TuriSc/portami/midi_interface.ino

/*
 * Copyright (c) 2021 Marcel Licence
 *
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
 * Dieses Programm ist Freie Software: Sie können es unter den Bedingungen
 * der GNU General Public License, wie von der Free Software Foundation,
 * Version 3 der Lizenz oder (nach Ihrer Wahl) jeder neueren
 * veröffentlichten Version, weiter verteilen und/oder modifizieren.
 *
 * Dieses Programm wird in der Hoffnung bereitgestellt, dass es nützlich sein wird, jedoch
 * OHNE JEDE GEWÄHR,; sogar ohne die implizite
 * Gewähr der MARKTFÄHIGKEIT oder EIGNUNG FÜR EINEN BESTIMMTEN ZWECK.
 * Siehe die GNU General Public License für weitere Einzelheiten.
 *
 * Sie sollten eine Kopie der GNU General Public License zusammen mit diesem
 * Programm erhalten haben. Wenn nicht, siehe <https://www.gnu.org/licenses/>.
 */

/**
 * @file midi_interface.ino
 * @author Marcel Licence
 * @date 22.10.2021
 *
 * @brief This file contains an implementation of a simple MIDI interpreter to parse incoming messages
 *
 * @see https://www.midi.org/specifications-old/item/table-1-summary-of-midi-message
 *
 * @contribution 18.12.2022 by Turi Scandurra: switching reading data from serial to USB
 */


#ifdef __CDT_PARSER__
#include <cdt.h>
#endif
#include <Arduino.h>
#include <usbh_midi.h>
#include <usbhub.h>

USBHost UsbH;
USBHub Hub(&UsbH);
USBH_MIDI  Midi(&UsbH);

/* use define to dump midi data */
#define MIDI_DUMP_Serial1_TO_SERIAL

/*
 * look for midi interface using 1N136
 * to convert the MIDI din signal to
 * a uart compatible signal
 */

#ifndef MIDI_SERIAL1_BAUDRATE
#define MIDI_SERIAL1_BAUDRATE   115200 // 31250
#endif


/*
 * structure is used to build the mapping table
 */
struct midiControllerMapping
{
    uint8_t channel;
    uint8_t data1;
    const char *desc;
    void(*callback_mid)(uint8_t ch, uint8_t data1, uint8_t data2);
    void(*callback_val)(uint8_t userdata, float value);
    uint8_t user_data;
};

struct midiMapping_s
{
    void (*rawMsg)(uint8_t *msg);
    void (*noteOn)(uint8_t ch, uint8_t note, float vel);
    void (*noteOff)(uint8_t ch, uint8_t note);
    void (*pitchBend)(uint8_t ch, float bend);
    void (*modWheel)(uint8_t ch, float value);

    struct midiControllerMapping *controlMapping;
    int mapSize;
};

extern struct midiMapping_s midiMapping; /* definition in z_config.ino */

/* constant to normalize midi value to 0.0 - 1.0f */
#define NORM127MUL  0.007874f

inline void Midi_NoteOn(uint8_t ch, uint8_t note, uint8_t vel)
{
    if (vel > 127)
    {
        /* we will end up here in case of problems with the MIDI connection or a bug in the parser */
        vel = 127;
        Serial.printf("to loud note detected!!!!!!!!!!!!!!!!!!!!!!!\n");
    }

    if (midiMapping.noteOn != NULL)
    {
        midiMapping.noteOn(ch, note, pow(2, ((vel * NORM127MUL) - 1.0f) * 6));
    }
}

inline void Midi_NoteOff(uint8_t ch, uint8_t note)
{
    if (midiMapping.noteOff != NULL)
    {
        midiMapping.noteOff(ch, note);
    }
}

/*
 * this function will be called when a control change message has been received
 */
inline void Midi_ControlChange(uint8_t channel, uint8_t data1, uint8_t data2)
{
    for (int i = 0; i < midiMapping.mapSize; i++)
    {
        if ((midiMapping.controlMapping[i].channel == channel) && (midiMapping.controlMapping[i].data1 == data1))
        {
            if (midiMapping.controlMapping[i].callback_mid != NULL)
            {
                midiMapping.controlMapping[i].callback_mid(channel, data1, data2);
            }
            if (midiMapping.controlMapping[i].callback_val != NULL)
            {
                midiMapping.controlMapping[i].callback_val(midiMapping.controlMapping[i].user_data, (float)data2 * NORM127MUL);
            }
        }
    }

    if (data1 == 1)
    {
        if (midiMapping.modWheel != NULL)
        {
            midiMapping.modWheel(channel, (float)data2 * NORM127MUL);
        }
    }
}

inline void Midi_PitchBend(uint8_t ch, uint16_t bend)
{
    float value = ((float)bend - 8192.0f) * (1.0f / 8192.0f) - 1.0f;
    if (midiMapping.pitchBend != NULL)
    {
        Serial.printf("PB: %d, %d, %d\n", ch, bend, (value * 1000.0f));
        midiMapping.pitchBend(ch, value);
    }
}

/*
 * function will be called when a short message has been received over midi
 */
inline void Midi_HandleShortMsg(uint8_t *data, uint8_t cable)
{
    uint8_t ch = data[0] & 0x0F;

    switch (data[0] & 0xF0)
    {
    /* note on */
    case 0x90:
        if (data[2] > 0)
        {
            Midi_NoteOn(ch, data[1], data[2]);
        }
        else
        {
            Midi_NoteOff(ch, data[1]);
        }
        break;
    /* note off */
    case 0x80:
        Midi_NoteOff(ch, data[1]);
        break;
    /* control change */
    case 0xb0:
        Midi_ControlChange(ch, data[1], data[2]);
        break;
    /* pitch bend */
    case 0xe0:
        Midi_PitchBend(ch, ((((uint16_t)data[1])) + ((uint16_t)data[2] << 8)));
        break;
    }
}

void Midi_Setup()
{
    Serial1.begin(MIDI_SERIAL1_BAUDRATE);
    if (UsbH.Init()) {
      Serial1.println("USB host did not start");
      while (1); //halt
    }

    while (!Serial);
    Serial1.println("Serial1 started");
}


inline
void Midi_CheckUSB(void)
{
  static uint8_t inMsg[3];
  char buf[20];
  uint8_t bufMidi[64];
  uint16_t  rcvd;

  if (Midi.RecvData(&rcvd,  bufMidi) == 0 ) {
    uint32_t time = (uint32_t)millis();
    sprintf(buf, "%04X%04X: ", (uint16_t)(time >> 16), (uint16_t)(time & 0xFFFF)); // Split variable to prevent warnings on the ESP8266 platform
    Serial1.print(buf);
    Serial1.print(rcvd);
    Serial1.print(':');
    for (int i = 0; i < 64; i++) {
      sprintf(buf, " %02X", bufMidi[i]);
      Serial1.print(buf);
    }
  }

  if(bufMidi[1] == 0x80 || bufMidi[1] == 0x90 || bufMidi[1] == 0xb0 || bufMidi[1] == 0xe0){
    inMsg[0] = bufMidi[1]; // Status: Note On, Note Off…
    inMsg[1] = bufMidi[2]; // Data 1: Note Number, Program Number…
    inMsg[2] = bufMidi[3]; // Data 2: Velocity, Pressure…
    Midi_HandleShortMsg(inMsg, 0);
  }

}


/*
 * this function should be called continuously to ensure that incoming messages can be processed
 */
inline
void Midi_Process()
{
    if ( Midi ) {
      Midi_CheckUSB();
    }
}
