TuriSc/portami/z_config.ino

/*
 * Copyright (c) 2021 Marcel Licence
 *
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
 * Dieses Programm ist Freie Software: Sie können es unter den Bedingungen
 * der GNU General Public License, wie von der Free Software Foundation,
 * Version 3 der Lizenz oder (nach Ihrer Wahl) jeder neueren
 * veröffentlichten Version, weiter verteilen und/oder modifizieren.
 *
 * Dieses Programm wird in der Hoffnung bereitgestellt, dass es nützlich sein wird, jedoch
 * OHNE JEDE GEWÄHR,; sogar ohne die implizite
 * Gewähr der MARKTFÄHIGKEIT oder EIGNUNG FÜR EINEN BESTIMMTEN ZWECK.
 * Siehe die GNU General Public License für weitere Einzelheiten.
 *
 * Sie sollten eine Kopie der GNU General Public License zusammen mit diesem
 * Programm erhalten haben. Wenn nicht, siehe <https://www.gnu.org/licenses/>.
 */

/**
 * @file z_config.ino
 * @author Marcel Licence
 * @date 15.05.2021
 *
 * @brief This file contains the mapping configuration
 * Put all your project configuration here (no defines etc)
 * This file will be included at the and can access all
 * declarations and type definitions
 *
 * @see ESP32 Arduino DIY Synthesizer Projects - Little startup guide to get your MIDI synth working - https://youtu.be/ZNxGCB-d68g
 *
 * @contribution 18.12.2022 by Turi Scandurra: added mapping for AKAI MPK Mini Play
 */

#ifdef __CDT_PARSER__
#include <cdt.h>
#endif


/*
 * this mapping is used for the edirol pcr-800
 * this should be changed when using another controller
 */
struct midiControllerMapping edirolMapping[] =
{
    /* transport buttons */
    { 0x8, 0x52, "back", NULL, NULL, 0},
    { 0xD, 0x52, "stop", NULL, NULL, 0},
    { 0xe, 0x52, "start", NULL, NULL, 0},
    { 0xe, 0x52, "start", NULL, NULL, 0},
    { 0xa, 0x52, "rec", NULL, NULL, 0},

    /* upper row of buttons */
    { 0x0, 0x50, "A1", NULL, NULL, 0},
    { 0x1, 0x50, "A2", NULL, NULL, 1},
    { 0x2, 0x50, "A3", NULL, NULL, 2},
    { 0x3, 0x50, "A4", NULL, NULL, 3},

    { 0x4, 0x50, "A5", NULL, NULL, 0},
    { 0x5, 0x50, "A6", NULL, NULL, 1},
    { 0x6, 0x50, "A7", NULL, NULL, 2},
    { 0x7, 0x50, "A8", NULL, NULL, 3},

    { 0x0, 0x53, "A9", NULL, NULL, 0},

    /* lower row of buttons */
    { 0x0, 0x51, "B1", NULL, NULL, 0},
    { 0x1, 0x51, "B2", NULL, NULL, 1},
    { 0x2, 0x51, "B3", NULL, NULL, 2},
    { 0x3, 0x51, "B4", NULL, NULL, 3},

    { 0x4, 0x51, "B5", NULL, NULL, 4},
    { 0x5, 0x51, "B6", NULL, NULL, 5},
    { 0x6, 0x51, "B7", NULL, NULL, 6},
    { 0x7, 0x51, "B8", NULL, NULL, 7},

    { 0x1, 0x53, "B9", NULL, NULL, 8},

    /* pedal */
    { 0x0, 0x0b, "VolumePedal", NULL, NULL, 0},

    /* slider */
    { 0x0, 0x11, "S1", NULL, Synth_ModulationWheel, 0},
    { 0x1, 0x11, "S2", NULL, NULL, 1},
    { 0x2, 0x11, "S3", NULL, NULL, 2},
    { 0x3, 0x11, "S4", NULL, NULL, 3},

    { 0x4, 0x11, "S5", NULL, NULL, 4},
    { 0x5, 0x11, "S6", NULL, NULL, 5},
    { 0x6, 0x11, "S7", NULL, NULL, 6},
    { 0x7, 0x11, "S8", NULL, NULL, 7},

    { 0x1, 0x12, "S9", NULL, NULL, 8},

    /* rotary */
    { 0x0, 0x10, "R1", NULL, Synth_SetParam, SYNTH_PARAM_WAVEFORM_1},
    { 0x1, 0x10, "R2", NULL, Synth_SetParam, SYNTH_PARAM_WAVEFORM_2},
    { 0x2, 0x10, "R3", NULL, Synth_SetParam, SYNTH_PARAM_MODULATION_PITCH},
    { 0x3, 0x10, "R4", NULL, Synth_SetParam, SYNTH_PARAM_MODULATION_SPEED},

    { 0x4, 0x10, "R5", NULL, Synth_SetParam, SYNTH_PARAM_PITCH_BEND_RANGE},
    { 0x5, 0x10, "R6", NULL, NULL, 0},
    { 0x6, 0x10, "R7", NULL, Delay_SetFeedback, 0},
    { 0x7, 0x10, "R8", NULL, Delay_SetLevel, 0},

    { 0x0, 0x12, "R9", NULL, NULL, 0},

    /* Central slider */
    { 0x0, 0x13, "H1", NULL, Synth_ModulationWheel, 0},

    /*
     * USB keyboard mapping
     */
    /* F1 - F12 */
    { 0x0, 0x3A, "F1", NULL, Synth_FuncF, 0},
    { 0x0, 0x3B, "F2", NULL, Synth_FuncF, 1},
    { 0x0, 0x3C, "F3", NULL, Synth_FuncF, 2},
    { 0x0, 0x3D, "F4", NULL, Synth_FuncF, 3},

    { 0x0, 0x3E, "F5", NULL, Synth_FuncF, 4},
    { 0x0, 0x3F, "F6", NULL, Synth_FuncF, 5},
    { 0x0, 0x40, "F7", NULL, Synth_FuncF, 6},
    { 0x0, 0x41, "F8", NULL, Synth_FuncF, 7},

    { 0x0, 0x42, "F9", NULL, Synth_FuncF, 8},
    { 0x0, 0x43, "F10", NULL, Synth_FuncF, 9},
    { 0x0, 0x44, "F11", NULL, Synth_FuncF, 10},
    { 0x0, 0x45, "F12", NULL, Synth_FuncF, 11},

    /* arrow keys */
    { 0x0, 0x4F, "Arr-R", NULL, Synth_Noise, 1},
    { 0x0, 0x50, "Arr-L", NULL, Synth_Noise, 2},
    { 0x0, 0x51, "Arr-D", NULL, Synth_Noise, 4},
    { 0x0, 0x52, "Arr-U", NULL, Synth_Noise, 8},
};

/*
 * mapping for AKAI MPK Mini Play
 */
struct midiControllerMapping akaiMPKMiniPlayMapping[] = 
{
  /* {channel, control change number, description, callback_mid, callback_val, user_data} */
  { 0x0, 0x10, "Joystick-Y", NULL, Synth_ModulationWheel, 0},
  { 0x0, 0x30, "Knob1", NULL, Delay_SetLevel, 0},
  { 0x0, 0x31, "Knob2", NULL, Delay_SetFeedback, 0},
  { 0x0, 0x32, "Knob3", NULL, Synth_SetParam, SYNTH_PARAM_MODULATION_SPEED},
  { 0x0, 0x33, "Knob4", NULL, Synth_SetParam, SYNTH_PARAM_PITCH_BEND_RANGE},
  { 0x0, 0x34, "Knob5", NULL, Synth_SetParam, SYNTH_PARAM_WAVEFORM_1},
  { 0x0, 0x35, "Knob6", NULL, Synth_SetParam, SYNTH_PARAM_WAVEFORM_2},
  // { 0x0, 0x??, "??", NULL, Synth_SetParam, SYNTH_PARAM_MODULATION_PITCH},  

};

/*
{pattern="b? 46 xx", name="Knob 1"},
        {pattern="b? 47 xx", name="Knob 2"},
        {pattern="b? 48 xx", name="Knob 3"},
        {pattern="b? 49 xx", name="Knob 4"},
        {pattern="b? 4a xx", name="Knob 5"},
        {pattern="b? 4b xx", name="Knob 6"},
        {pattern="b? 4c xx", name="Knob 7"},
        {pattern="b? 4d xx", name="Knob 8"},
*/

struct midiMapping_s midiMapping =
{
    NULL,
    Synth_NoteOn,
    Synth_NoteOff,
    Synth_PitchBend,
    Synth_ModulationWheel,
    akaiMPKMiniPlayMapping,
    sizeof(akaiMPKMiniPlayMapping) / sizeof(akaiMPKMiniPlayMapping[0]),
};
